yamimah0849-dot/emg-hand/(commit log)

2026-10-09 Initial commit: EMG Hand proof of concept
    Arduino sketch that streams EMG readings over USB, browser app that drives a 3D hand from them, and project README.
2026-10-09 Remove ESP32-S3 from hardware list (not used in the build)
2026-10-09 Identify the EMG sensor board in the hardware list
2026-10-09 Use the sensor board's real pin names in the wiring table
2026-10-09 Fill in build details: symptom, fix, measurements, electrodes, app role
2026-10-09 Confirm wiring; remove last placeholder
